MuddSub/crush-power-board/crush-power-board.kicad_pcb

## KiCad design crush-power-board.kicad_pcb (2025-03-31)

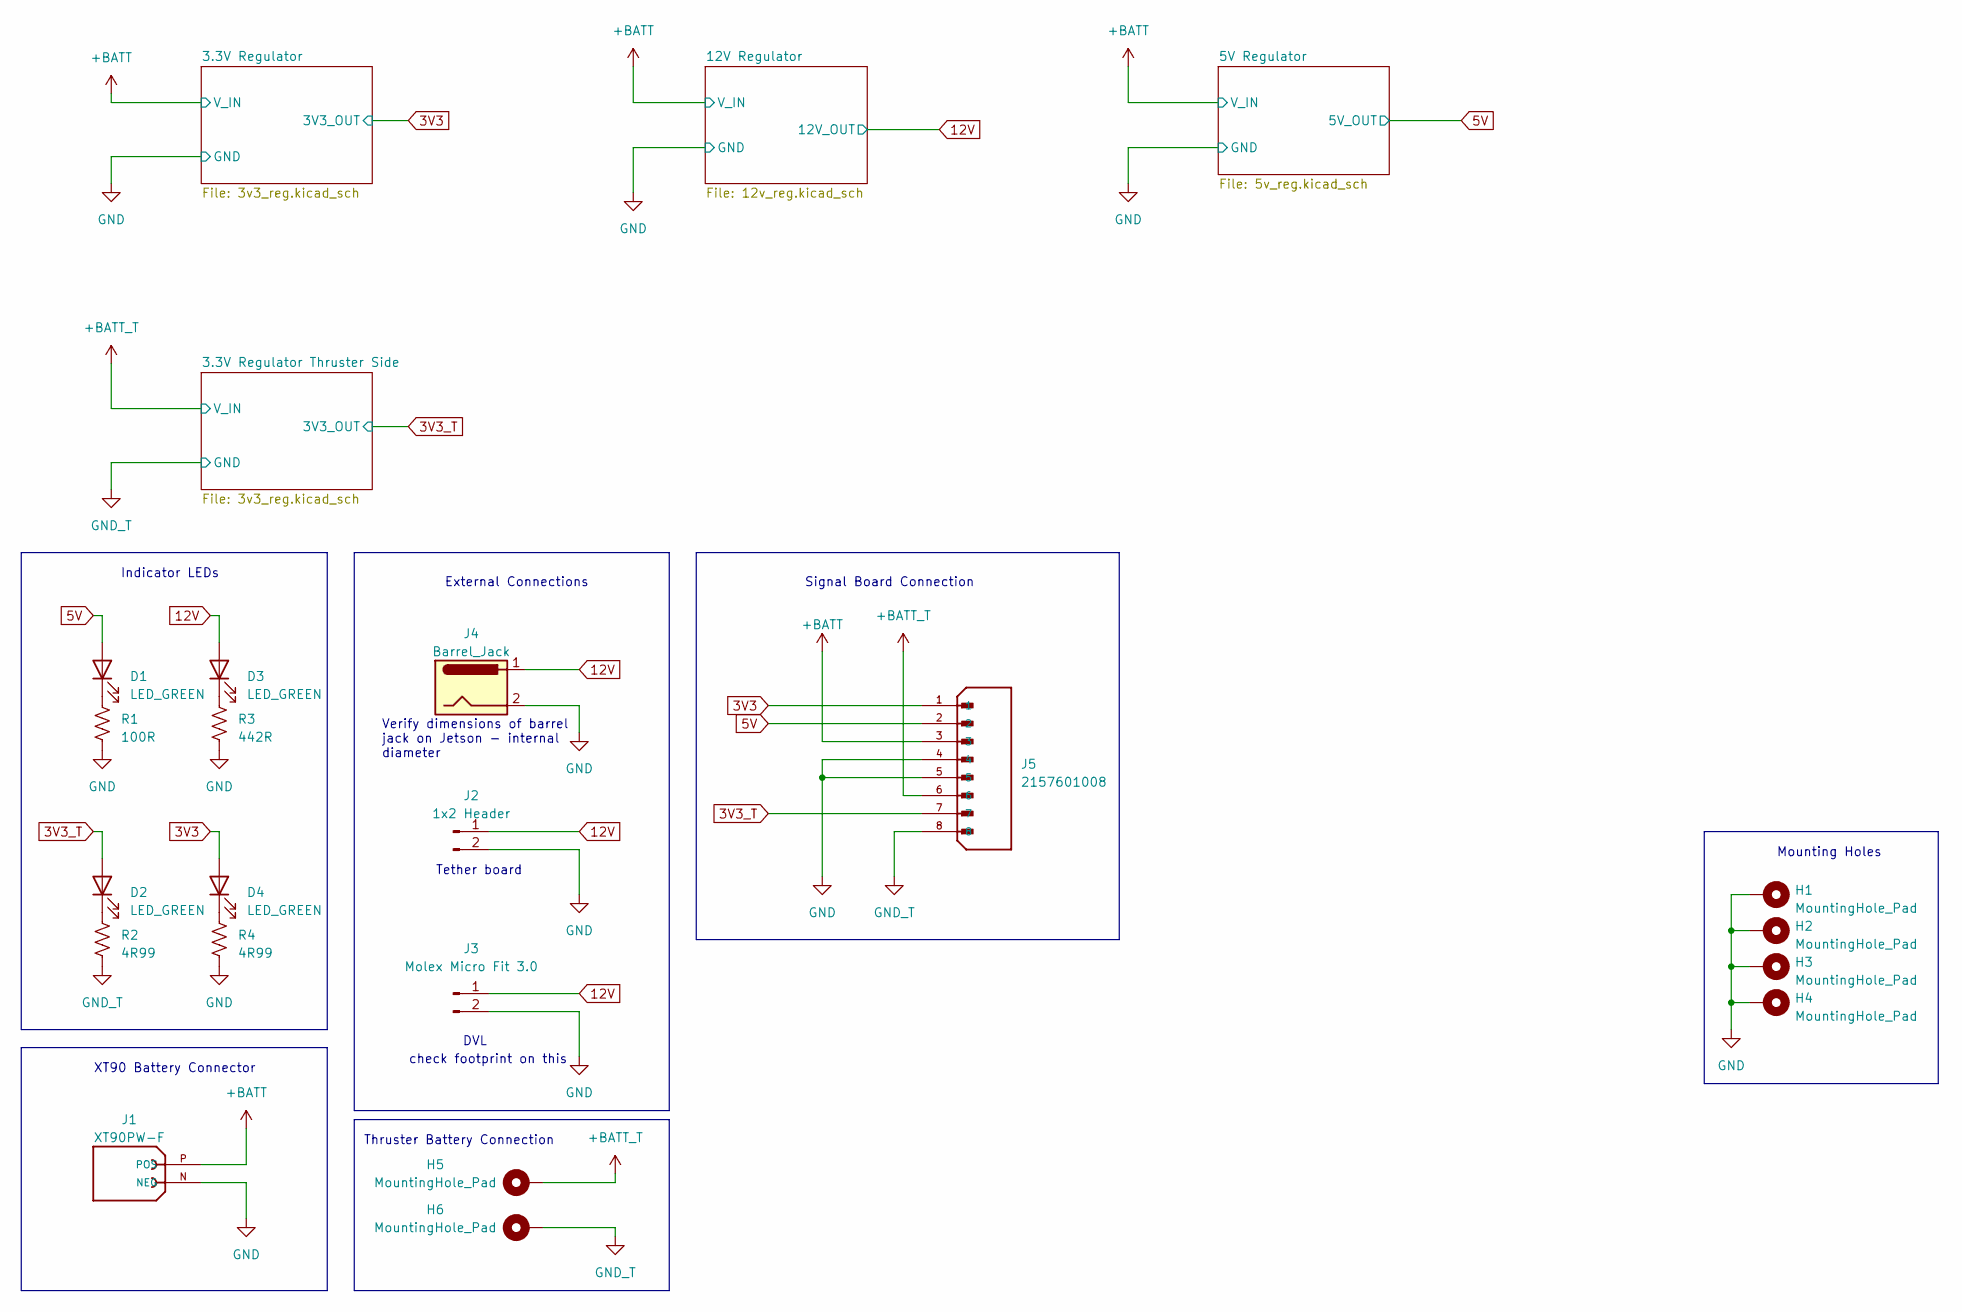
[picture p1: schematic crush-power-board.kicad_sch]

Parts:
D1, D2, D3, D4: LED_GREEN; LED_0603_1608Metric
H1, H2, H3, H4: MountingHole_Pad; MountingHole_3.7mm_Pad_Via
H5, H6: MountingHole_Pad; MountingHole_4.5mm_Pad_Via
J1: XT90PW-F; AMASS_XT90PW-F; PARTREV V00
J2: 1x2 Header; PinHeader_1x02_P2.54mm_Vertical
J3: Molex Micro Fit 3.0; Molex_Micro-Fit_3.0_43045-0212_2x01_P3.00mm_Vertical
J4: Barrel_Jack; BarrelJack_Horizontal
J5: 2157601008; MOLEX_2157601008; PARTREV A1
R1: 100R; R_0603_1608Metric
R2, R4: 4R99; R_0603_1608Metric
R3: 442R; R_0603_1608Metric

Connections:
3V3: D4.2 (A), J5.1; also elsewhere on the board
3V3_T: D2.2 (A), J5.7; also elsewhere on the board
5V: D1.2 (A), J5.2; also elsewhere on the board
12V: D3.2 (A), J2.1, J3.1, J4.1; also elsewhere on the board
+BATT: J1.P (POS), J5.3; also elsewhere on the board
+BATT_T: H5.1, J5.6; also elsewhere on the board
GND: H1.1, H2.1, H3.1, H4.1, J1.N (NEG), J2.2, J3.2, J4.2, J5.4, J5.5, R1.2, R3.2, R4.2; also elsewhere on the board
GND1: H6.1, J5.8, R2.2; also elsewhere on the board
unnamed: D1.1 (K), R1.1
unnamed: D2.1 (K), R2.1
unnamed: D3.1 (K), R3.1
unnamed: D4.1 (K), R4.1

Notes on the sheet:
check footprint on this
Indicator LEDs
Mounting Holes
DVL
Signal Board Connection
External Connections
XT90 Battery Connector
Thruster Battery Connection
Verify dimensions of barrel jack on Jetson - internal diameter
Tether board

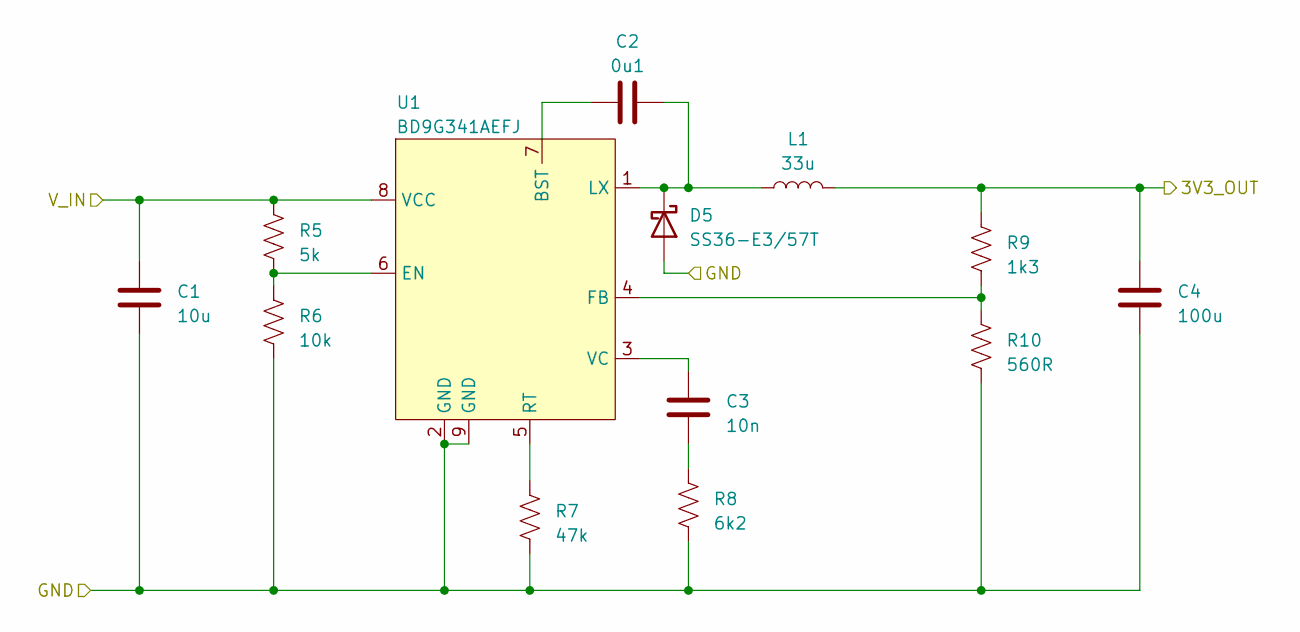
[picture p2: schematic 3v3_reg.kicad_sch]

Parts:
C1: 10u; C_0603_1608Metric
C2: 0u1; C_0603_1608Metric
C3: 10n; C_0603_1608Metric
C4: 100u; C_1206_3216Metric
D5: SS36-E3/57T; DIODE_DO214AB
L1: 33u; IND_#B953AS-330M=P3
R5: 5k; R_0603_1608Metric
R6: 10k; R_0603_1608Metric
R7: 47k; R_0603_1608Metric
R8: 6k2; R_0603_1608Metric
R9: 1k3; R_0603_1608Metric
R10: 560R; R_0603_1608Metric
U1: BD9G341AEFJ; SOIC127P600X100-9N

Connections:
3V3: C4.1, L1.2, R9.1; also elsewhere on the board
+BATT: C1.1, R5.1, U1.8 (VCC); also elsewhere on the board
GND: C1.2, C4.2, D5.2 (A), R6.2, R7.2, R8.2, R10.2, U1.2 (GND), U1.9 (GND); also elsewhere on the board
unnamed: C3.2, R8.1
unnamed: C2.2, D5.1 (K), L1.1, U1.1 (LX)
unnamed: C2.1, U1.7 (BST)
unnamed: R5.2, R6.1, U1.6 (EN)
unnamed: R9.2, R10.1, U1.4 (FB)
unnamed: R7.1, U1.5 (RT)
unnamed: C3.1, U1.3 (VC)

Parts of its further copies:
C45: 10u; C_0603_1608Metric
C46: 0u1; C_0603_1608Metric
C47: 10n; C_0603_1608Metric
C48: 100u; C_1206_3216Metric
D6: SS36-E3/57T; DIODE_DO214AB
L4: 33u; IND_#B953AS-330M=P3
R33: 5k; R_0603_1608Metric
R34: 10k; R_0603_1608Metric
R35: 47k; R_0603_1608Metric
R36: 6k2; R_0603_1608Metric
R37: 1k3; R_0603_1608Metric
R38: 560R; R_0603_1608Metric
U4: BD9G341AEFJ; SOIC127P600X100-9N

Connections of its further copies:
3V3_T: C48.1, L4.2, R37.1; also elsewhere on the board
+BATT_T: C45.1, R33.1, U4.8 (VCC); also elsewhere on the board
GND1: C45.2, C48.2, D6.2 (A), R34.2, R35.2, R36.2, R38.2, U4.2 (GND), U4.9 (GND); also elsewhere on the board
unnamed: C47.2, R36.1
unnamed: C46.2, D6.1 (K), L4.1, U4.1 (LX)
unnamed: C46.1, U4.7 (BST)
unnamed: R33.2, R34.1, U4.6 (EN)
unnamed: R37.2, R38.1, U4.4 (FB)
unnamed: R35.1, U4.5 (RT)
unnamed: C47.1, U4.3 (VC)

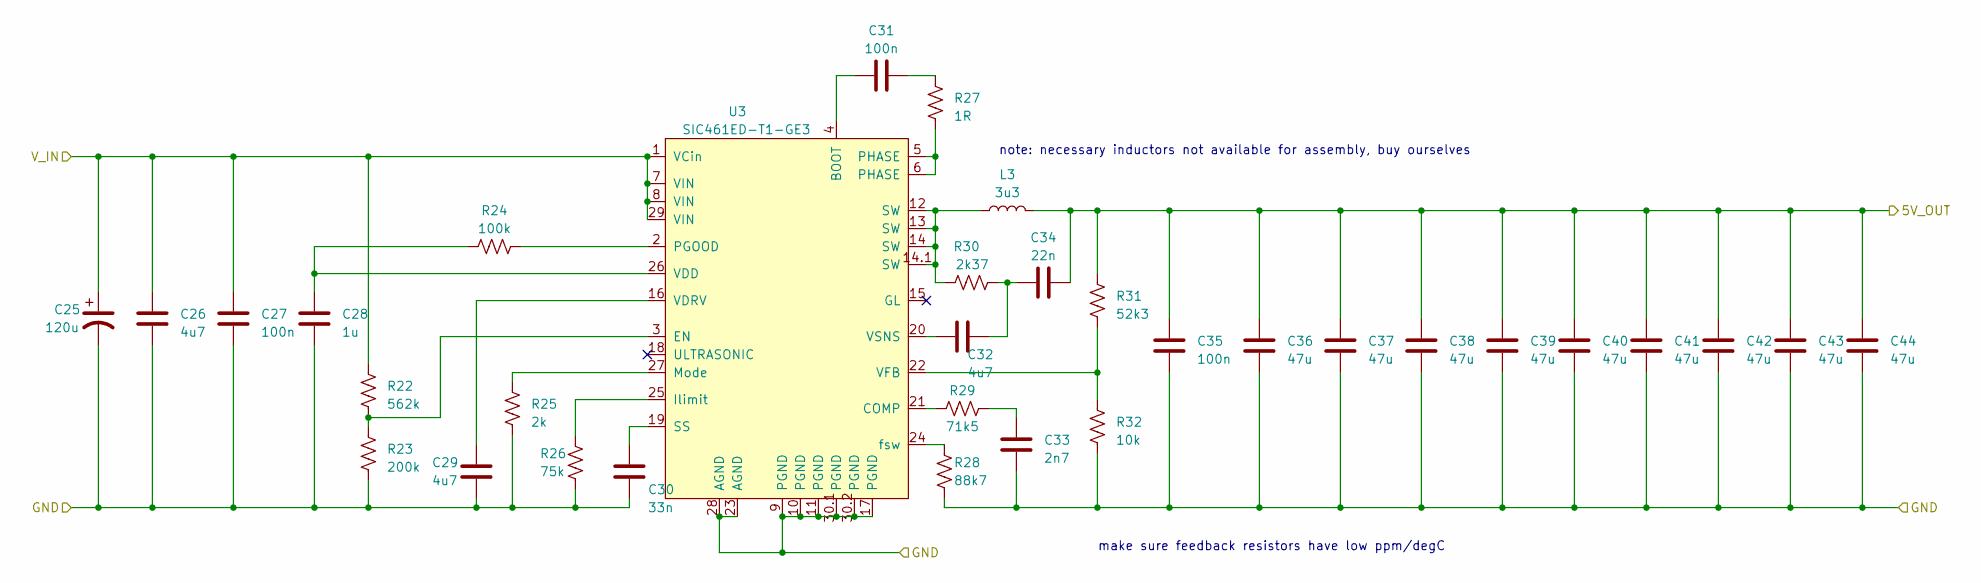
[picture p3: schematic 5v_reg.kicad_sch]

Parts:
C25: 120u; CP_Radial_D8.0mm_P3.50mm
C26: 4u7; C_0603_1608Metric
C27, C35: 100n; C_0603_1608Metric
C28: 1u; C_0603_1608Metric
C29, C32: 4u7; C_0805_2012Metric
C30: 33n; C_0603_1608Metric
C31: 100n; C_0402_1005Metric
C33: 2n7; C_0603_1608Metric
C34: 22n; C_0402_1005Metric
C36, C37, C38, C39, C40, C41, C42, C43, C44: 47u; C_1210_3225Metric
L3: 3u3; IND_IHLP-6767GZ_VIS-M
R22: 562k; R_0603_1608Metric
R23: 200k; R_0603_1608Metric
R24: 100k; R_0603_1608Metric
R25: 2k; R_0603_1608Metric
R26: 75k; R_0603_1608Metric
R27: 1R; R_0402_1005Metric
R28: 88k7; R_0603_1608Metric
R29: 71k5; R_0402_1005Metric
R30: 2k37; R_0402_1005Metric
R31: 52k3; R_0603_1608Metric
R32: 10k; R_0603_1608Metric
U3: SIC461ED-T1-GE3; CONV_SIC461ED-T1-GE3; PARTREV M

Connections:
5V: C34.2, C35.1, C36.1, C37.1, C38.1, C39.1, C40.1, C41.1, C42.1, C43.1, C44.1, L3.2, R31.1; also elsewhere on the board
+BATT: C25.1, C26.2, C27.2, R22.2, U3.1 (VCin), U3.7 (VIN), U3.8 (VIN), U3.29 (VIN); also elsewhere on the board
GND: C25.2, C26.1, C27.1, C28.1, C29.1, C30.1, C33.2, C35.2, C36.2, C37.2, C38.2, C39.2, C40.2, C41.2, C42.2, C43.2, C44.2, R23.1, R25.2, R26.2, R28.2, R32.2, U3.9 (PGND), U3.10 (PGND), U3.11 (PGND), U3.17 (PGND), U3.23 (AGND), U3.28 (AGND), U3.30.1 (PGND), U3.30.2 (PGND); also elsewhere on the board
unnamed: C31.2, R27.2
unnamed: C32.2, C34.1, R30.2
unnamed: C33.1, R29.2
unnamed: L3.1, R30.1, U3.12 (SW), U3.13 (SW), U3.14 (SW), U3.14.1 (SW)
unnamed: R27.1, U3.5 (PHASE), U3.6 (PHASE)
unnamed: C31.1, U3.4 (BOOT)
unnamed: R29.1, U3.21 (COMP)
unnamed: R22.1, R23.2, U3.3 (EN)
unnamed: R26.1, U3.25 (Ilimit)
unnamed: R25.1, U3.27 (Mode)
unnamed: R24.2, U3.2 (PGOOD)
unnamed: C30.2, U3.19 (SS)
unnamed: C28.2, R24.1, U3.26 (VDD)
unnamed: C29.2, U3.16 (VDRV)
unnamed: R31.2, R32.1, U3.22 (VFB)
unnamed: C32.1, U3.20 (VSNS)
unnamed: R28.1, U3.24 (fsw)

Notes on the sheet:
make sure feedback resistors have low ppm/degC
note: necessary inductors not available for assembly, buy ourselves

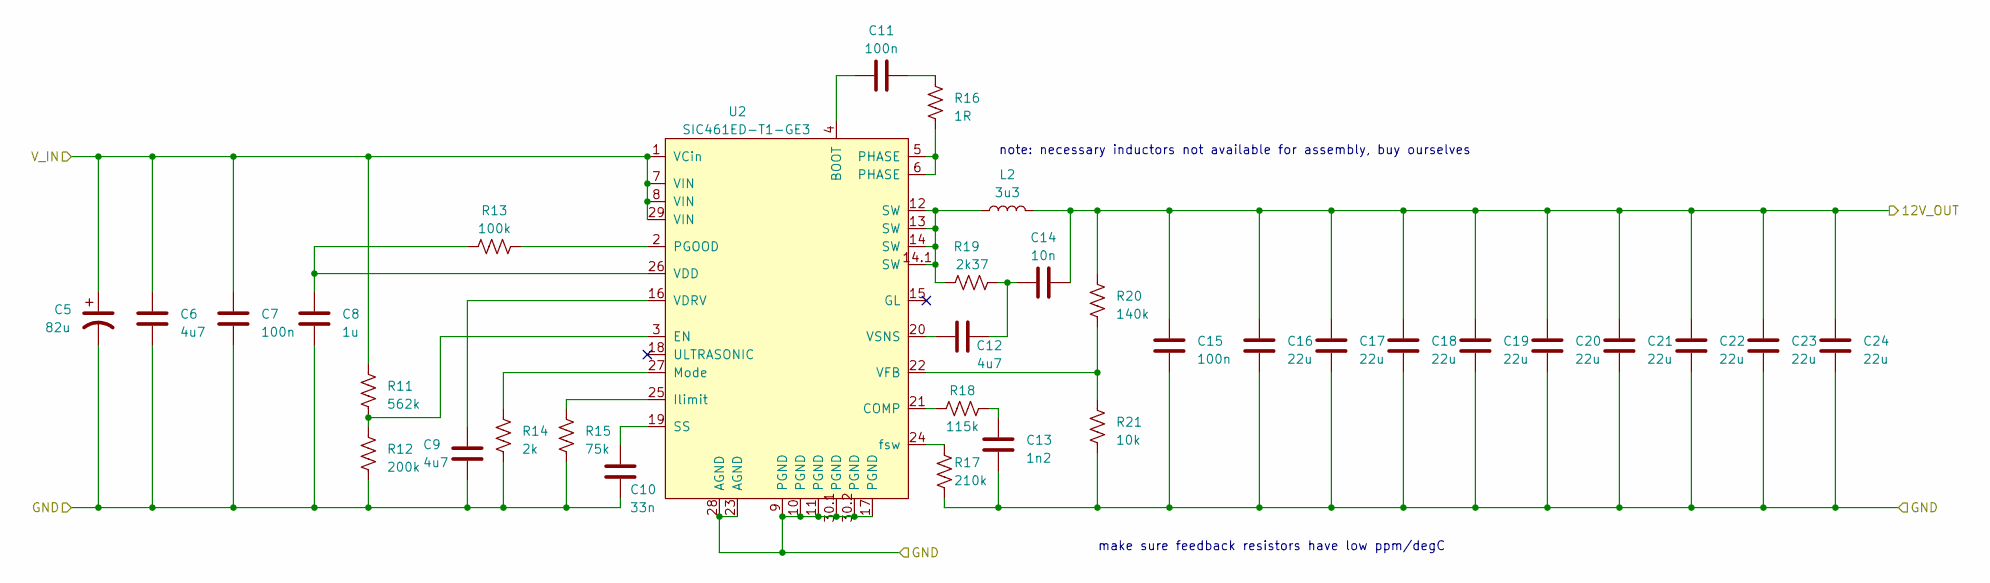
[picture p4: schematic 12v_reg.kicad_sch]

Parts:
C5: 82u; CP_Radial_D8.0mm_P3.50mm
C6: 4u7; C_0603_1608Metric
C7, C15: 100n; C_0603_1608Metric
C8: 1u; C_0603_1608Metric
C9, C12: 4u7; C_0805_2012Metric
C10: 33n; C_0603_1608Metric
C11: 100n; C_0402_1005Metric
C13: 1n2; C_0603_1608Metric
C14: 10n; C_0402_1005Metric
C16, C17, C18, C19, C20, C21, C22, C23, C24: 22u; C_1210_3225Metric
L2: 3u3; IND_IHLP-6767GZ_VIS-M
R11: 562k; R_0603_1608Metric
R12: 200k; R_0603_1608Metric
R13: 100k; R_0603_1608Metric
R14: 2k; R_0603_1608Metric
R15: 75k; R_0603_1608Metric
R16: 1R; R_0402_1005Metric
R17: 210k; R_0603_1608Metric
R18: 115k; R_0402_1005Metric
R19: 2k37; R_0402_1005Metric
R20: 140k; R_0603_1608Metric
R21: 10k; R_0603_1608Metric
U2: SIC461ED-T1-GE3; CONV_SIC461ED-T1-GE3; PARTREV M

Connections:
12V: C14.2, C15.1, C16.1, C17.1, C18.1, C19.1, C20.1, C21.1, C22.1, C23.1, C24.1, L2.2, R20.1; also elsewhere on the board
+BATT: C5.1, C6.2, C7.2, R11.2, U2.1 (VCin), U2.7 (VIN), U2.8 (VIN), U2.29 (VIN); also elsewhere on the board
GND: C5.2, C6.1, C7.1, C8.1, C9.1, C10.1, C13.2, C15.2, C16.2, C17.2, C18.2, C19.2, C20.2, C21.2, C22.2, C23.2, C24.2, R12.1, R14.2, R15.2, R17.2, R21.2, U2.9 (PGND), U2.10 (PGND), U2.11 (PGND), U2.17 (PGND), U2.23 (AGND), U2.28 (AGND), U2.30.1 (PGND), U2.30.2 (PGND); also elsewhere on the board
unnamed: C11.2, R16.2
unnamed: C12.2, C14.1, R19.2
unnamed: C13.1, R18.2
unnamed: L2.1, R19.1, U2.12 (SW), U2.13 (SW), U2.14 (SW), U2.14.1 (SW)
unnamed: R16.1, U2.5 (PHASE), U2.6 (PHASE)
unnamed: C11.1, U2.4 (BOOT)
unnamed: R18.1, U2.21 (COMP)
unnamed: R11.1, R12.2, U2.3 (EN)
unnamed: R15.1, U2.25 (Ilimit)
unnamed: R14.1, U2.27 (Mode)
unnamed: R13.2, U2.2 (PGOOD)
unnamed: C10.2, U2.19 (SS)
unnamed: C8.2, R13.1, U2.26 (VDD)
unnamed: C9.2, U2.16 (VDRV)
unnamed: R20.2, R21.1, U2.22 (VFB)
unnamed: C12.1, U2.20 (VSNS)
unnamed: R17.1, U2.24 (fsw)

Notes on the sheet:
note: necessary inductors not available for assembly, buy ourselves
make sure feedback resistors have low ppm/degC

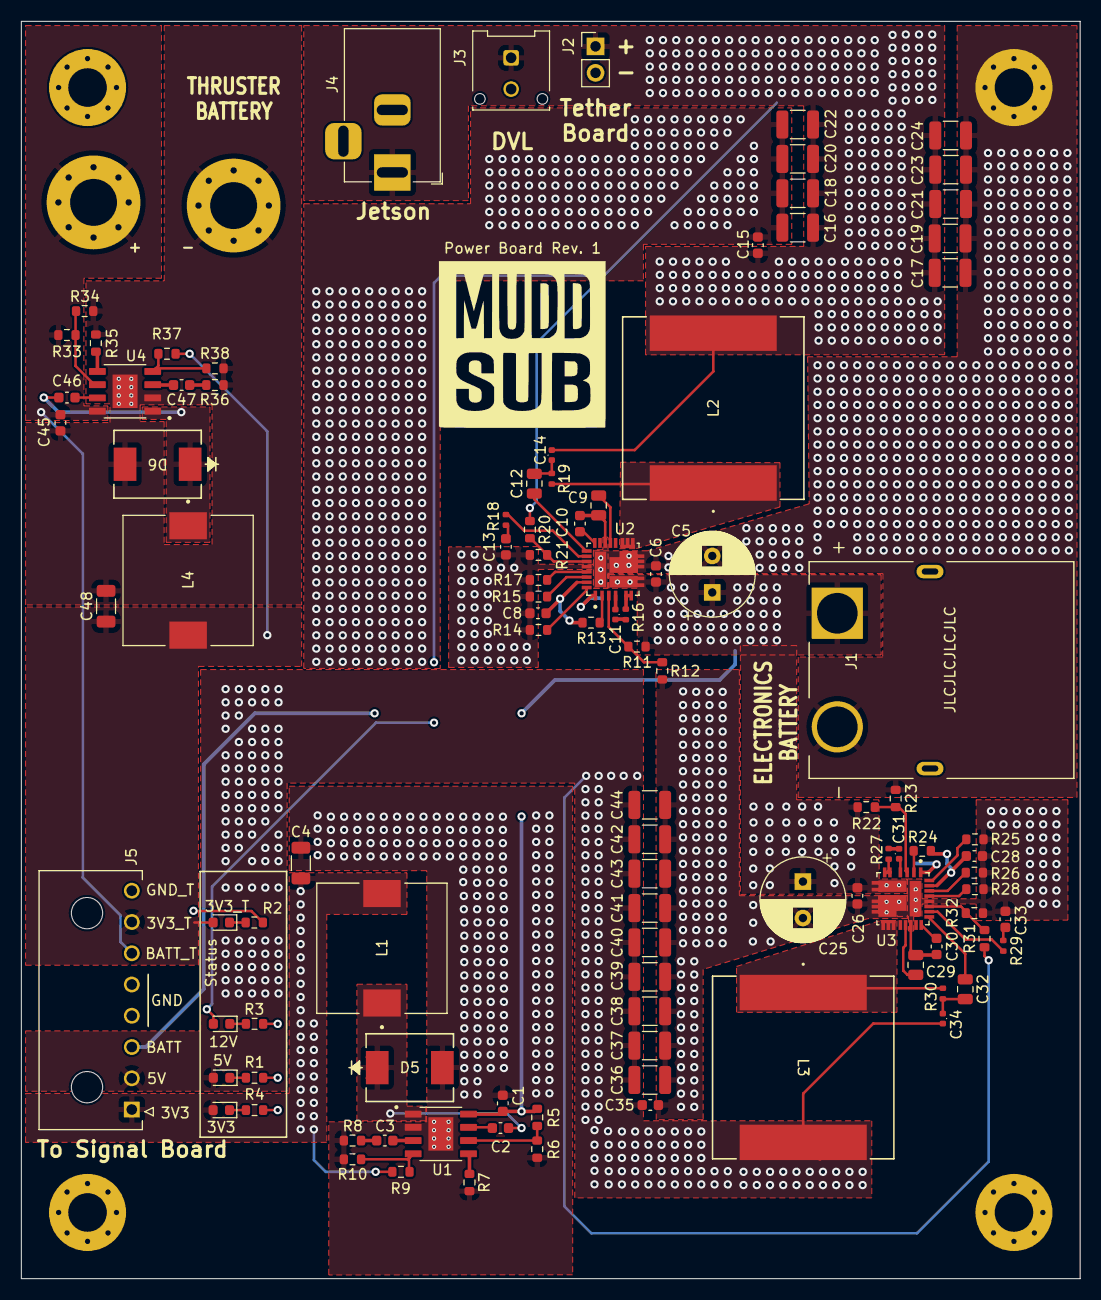
[picture p5: board crush-power-board.kicad_pcb from above]

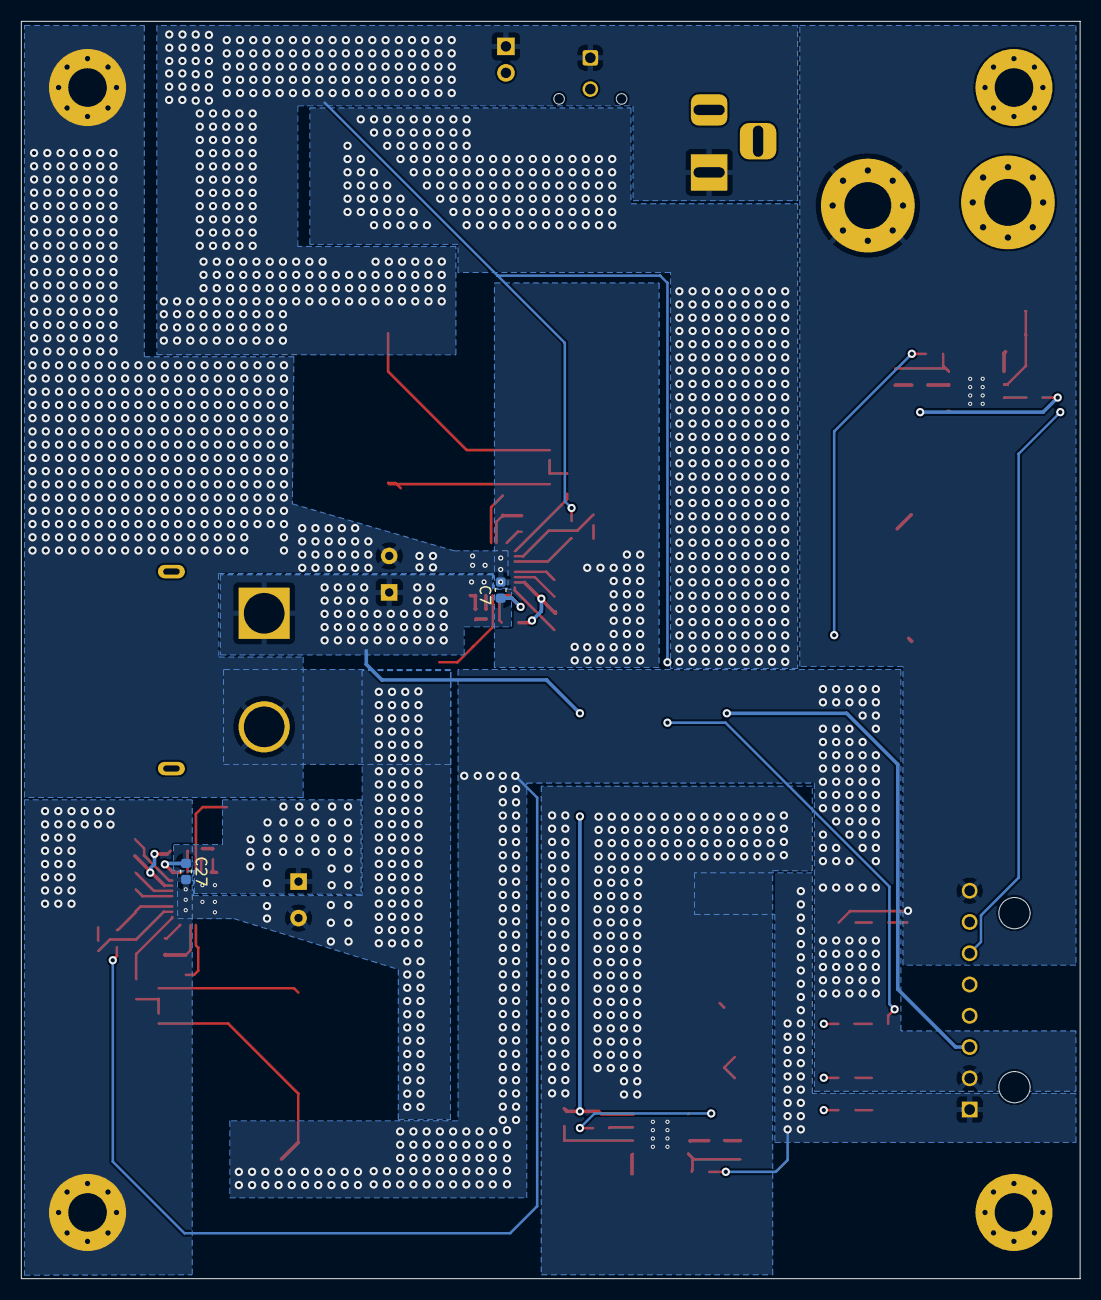
[picture p6: board crush-power-board.kicad_pcb from below]

Board: 4 copper layers, 101.6 x 120.6 mm, 111 parts (2 on the bottom side), 60 nets.
