MuddSub/crush-power-board/(threads)

Thread 6 (2025-02-02):

Review Board Design and Start Fabrication

CoolSpy3, 2025-02-02:
This task involves getting this board ready-to-fab by conducting a series of reviews with Prof. Spencer and fixing any issues that come up. Afterwards, this should be referred to the elex-lead, who should send this out for fabrication and create additional issues for assembly/testing/integration.

- [ ] Close outstanding issues/PRs
- [ ] Review the board design with Prof Spencer
- [ ] Fix any issues arising from review
- [ ] Conduct second review (add more steps if more issues need to be fixed)
- [ ] Send board files to a fab-house
