MuddSub/crush-power-board/(commit log)

2023-03-26 minor change
    [crush-power-board.kicad_sch]
2023-03-26 added all power regulator circuits
    [crush-power-board.kicad_sch]
2023-04-02 Added component values for the 3V3 regulator, cleaned up some schematics
    [crush-power-board.kicad_sch]
2023-04-08 Added values to components
    [crush-power-board.kicad_sch]
2023-04-09 Changed 3.3V Regulator, as well as added hierarchical elements to schematic
    [crush-power-board.kicad_sch]
2023-04-09 Added hierarchical schematics
    [12v_reg.kicad_sch, 3v3_reg.kicad_sch, 5v_reg.kicad_sch]
2023-04-09 Changed 12V Regulator values, added thruster side 3V3 regulator
    [12v_reg.kicad_sch, 3v3_reg.kicad_sch, crush-power-board.kicad_sch]
2023-04-10 Added extra output capacitance to 12V regulator, added component designators
    [12v_reg.kicad_sch, 5v_reg.kicad_sch]
2023-04-10 Added more component footprints
    [12v_reg.kicad_sch, 5v_reg.kicad_sch]
2023-04-16 Fixed a lot of components
    [12v_reg.kicad_sch, 3v3_reg.kicad_sch, 5v_reg.kicad_sch]
2023-04-17 Added extra footprints for diodes and capacitors
    [3v3_reg.kicad_sch, 5v_reg.kicad_sch, crush-power-board.kicad_pcb]
2023-04-17 Fixed reference designators
    [12v_reg.kicad_sch, 3v3_reg.kicad_sch, 5v_reg.kicad_sch, crush-power-board.kicad_sch]
2023-04-19 Added indicator LEDs and fixed some footprints
    [12v_reg.kicad_sch, 5v_reg.kicad_sch, crush-power-board.kicad_sch]
2023-04-19 fixed some more footprints for resistors. 0201 -> 0603
    [12v_reg.kicad_sch, 3v3_reg.kicad_sch, 5v_reg.kicad_sch]
2023-04-19 Changed boot/phase resistor and cap to be 0402 package according to SiC467 datasheet
    [12v_reg.kicad_sch]
2023-04-19 fixed some routing for 3v3 regulator
    [3v3_reg.kicad_sch]
2023-04-21 Added connections to signal board, battery, and mounting holes
    [12v_reg.kicad_sch, crush-power-board.kicad_sch]
2023-04-21 Added new connectors to library and updated gitignore
2023-04-22 Changed 5V regulator and 12V regulator to the SiC461. Both support 10A and 5V and 12V respectively
    [12v_reg.kicad_sch, 3v3_reg.kicad_sch, 5v_reg.kicad_sch, crush-power-board.kicad_sch]
2023-04-23 started pcb layout
    [crush-power-board.kicad_pcb]
2023-04-23 Changed schottky diode for 3.3V regulator
    [3v3_reg.kicad_sch]
2023-04-23 updated pcb layout
    [crush-power-board.kicad_pcb]
2023-04-24 Added more to the layout of the 12V regulator as well as changed some capacitor footprints
    [12v_reg.kicad_sch, 5v_reg.kicad_sch, crush-power-board.kicad_pcb, crush-power-board.kicad_sch]
2023-05-18 Finished layout for 12V regulator
    [crush-power-board.kicad_pcb]
2023-05-18 Added thermal vias to the 12V regulator, fixed GND pad nets on 12V and 5V regulator
    [12v_reg.kicad_sch, 5v_reg.kicad_sch, crush-power-board.kicad_pcb]
2023-09-23 change power board to 4 layers
    [crush-power-board.kicad_pcb]
2024-03-11 route 3v3 regulator
    [crush-power-board.kicad_pcb]
2024-03-11 switch inner routing to back plane
    [crush-power-board.kicad_pcb]
2024-03-11 add missing wire
    [crush-power-board.kicad_pcb]
2024-03-11 fix batt_t planes
    [12v_reg.kicad_sch, 5v_reg.kicad_sch, crush-power-board.kicad_pcb, crush-power-board.kicad_sch]
2024-03-11 route 3v3_T regulator
    [crush-power-board.kicad_pcb]
2024-03-11 route 5v regulator
    [crush-power-board.kicad_pcb]
2024-03-11 add 5v routing
    [crush-power-board.kicad_pcb]
2024-03-11 add missing vias
    [crush-power-board.kicad_pcb]
2024-03-11 move feedback trace to back layer
    [crush-power-board.kicad_pcb]
2024-03-11 Added more vias and plane differences to 5V reg
    [crush-power-board.kicad_pcb]
2024-03-11 start 12v routing
    [crush-power-board.kicad_pcb]
2024-03-11 run drc
    [crush-power-board.kicad_pcb]
2024-03-12 finish main 12v layout
    [crush-power-board.kicad_pcb]
2024-03-12 fix drc violations
    [crush-power-board.kicad_pcb]
2024-03-12 preparing for board layout
    [crush-power-board.kicad_pcb]
2024-03-14 layout majority of power board
    [crush-power-board.kicad_pcb]
2024-03-14 drc fixes and update schematic to reflect correct ic footprints
    [12v_reg.kicad_sch, 3v3_reg.kicad_sch, 5v_reg.kicad_sch, crush-power-board.kicad_pcb]
2024-03-14 realign zone boundaries
    [crush-power-board.kicad_pcb]
2024-03-14 move traces
    [crush-power-board.kicad_pcb]
2024-03-14 vias and silkscreen
    [crush-power-board.kicad_pcb]
2024-03-16 fix signal board connector orientation
    [crush-power-board.kicad_pcb]
2024-03-16 finish signal board connector routing
    [crush-power-board.kicad_pcb]
2024-03-16 resize zones
    [crush-power-board.kicad_pcb]
2024-03-17 3v3_t routing
    [crush-power-board.kicad_pcb]
2024-03-23 misc design fixes
    [crush-power-board.kicad_pcb]
2024-03-23 fix silkscreen drc violations
    [crush-power-board.kicad_pcb]
2024-04-06 update board size
    [crush-power-board.kicad_pcb]
2024-04-06 added mounting holes
    [crush-power-board.kicad_pcb, crush-power-board.kicad_sch]
2024-04-06 fix mounting hole alignment
    [crush-power-board.kicad_pcb]
2024-04-06 increase 12v plane size
    [crush-power-board.kicad_pcb]
2024-04-08 use 6-32 mounting holes
    [crush-power-board.kicad_pcb, crush-power-board.kicad_sch]
2024-04-27 label 12v status indicator
    [crush-power-board.kicad_pcb]
2024-04-27 cleanup traces/vias
    [crush-power-board.kicad_pcb]
2024-05-04 Silkscreen changes
    [crush-power-board.kicad_pcb]
2024-05-04 added JLC order number placement
    [crush-power-board.kicad_pcb]
2024-09-18 add thruster battery connection
    [crush-power-board.kicad_pcb, crush-power-board.kicad_sch]
2024-09-21 update for 8-32 screws
    [crush-power-board.kicad_pcb, crush-power-board.kicad_sch]
2024-09-23 remove unnecessary silkscreen text
    [crush-power-board.kicad_pcb]
2025-02-17 use 4u7 capacitors for vsns pins
    [12v_reg.kicad_sch, 5v_reg.kicad_sch, crush-power-board.kicad_pcb]
2025-02-17 fix footprint on 3v3 output capacitors
    [3v3_reg.kicad_sch, crush-power-board.kicad_pcb]
